EDSIndia/RCJ-Cluster/Documents/RCJ_Motor_Controller_CAN_Interface_Requirement_Specification (1).xlsx

RCJ Motor Controller CAN Interface Requirement Specification
SL.NO | CAN ID | Message Name | Cycle (ms) | DLC | Signal | Start Bit | Length (bits) | Signal Value Description | Requirement | Receiver | Remarks
1 | 0x230 | MCU_Status | 200 | 8 | Gear Position | 0 | 3 | 0=Invalid,1=Gear1,2=Gear2,3=Gear3,4=Reverse | Display current gear | Cluster
2 |  | MCU_Status | 200 | 8 | Brake Status | 3 | 1 | 0=OFF,1=ON | Brake indication | Cluster
3 |  | MCU_Status | 200 | 8 | Side Stand | 4 | 1 | 0=OFF,1=ON | Side stand alert | Cluster
4 |  | MCU_Status | 200 | 8 | Ready to Drive | 5 | 1 | 0=OFF,1=ON | Ready indicator | Cluster
5 |  | MCU_Status | 200 | 8 | Hall Sensor Fault | 6 | 1 | 0=No Fault,1=Fault | Fault indication | Cluster
6 |  | MCU_Status | 200 | 8 | Controller Fault | 7 | 1 | 0=No Fault,1=Fault | Controller fault | Cluster
7 |  | MCU_Status | 200 | 8 | Motor Fault | 8 | 1 | 0=No Fault,1=Fault | Motor fault | Cluster
8 |  | MCU_Status | 200 | 8 | Brake Warning | 9 | 1 | 0=No Fault,1=Fault | Brake error warning | Cluster
9 |  | MCU_Status | 200 | 8 | Throttle Error | 10 | 1 | 0=No Fault,1=Fault | Throttle error warning | Cluster
10 |  | MCU_Status | 200 | 8 | CAN Communication Fail | 11 | 1 | 0=OK,1=Fail | Communication failure | Cluster
11 |  | MCU_Status | 200 | 8 | Motor Temperature High | 12 | 1 | 0=Normal,1=High | Motor temperature high warning | Cluster
12 |  | MCU_Status | 200 | 8 | Parking status | 13 | 1 | 0 - OFF,1 - Parking | Vehicle parking status | Cluster
13 | 0x240 | MCU_Data | 200 | 8 | Vehicle Speed | 0 | 16 | km/hr | Display speedometer | Cluster
14 |  | MCU_Data | 200 | 8 | Motor Temperature | 16 | 16 | Temperature (°C) | Display motor temperature | Cluster
15 |  | MCU_Data | 200 | 8 | Odometer | 32 | 32 | Accumulated odo (km) | Display total vehicle runs | Cluster
