EDSIndia/RCJ-Cluster/Documents/DL0991-BL-W2-A.dwg-Model.pdf

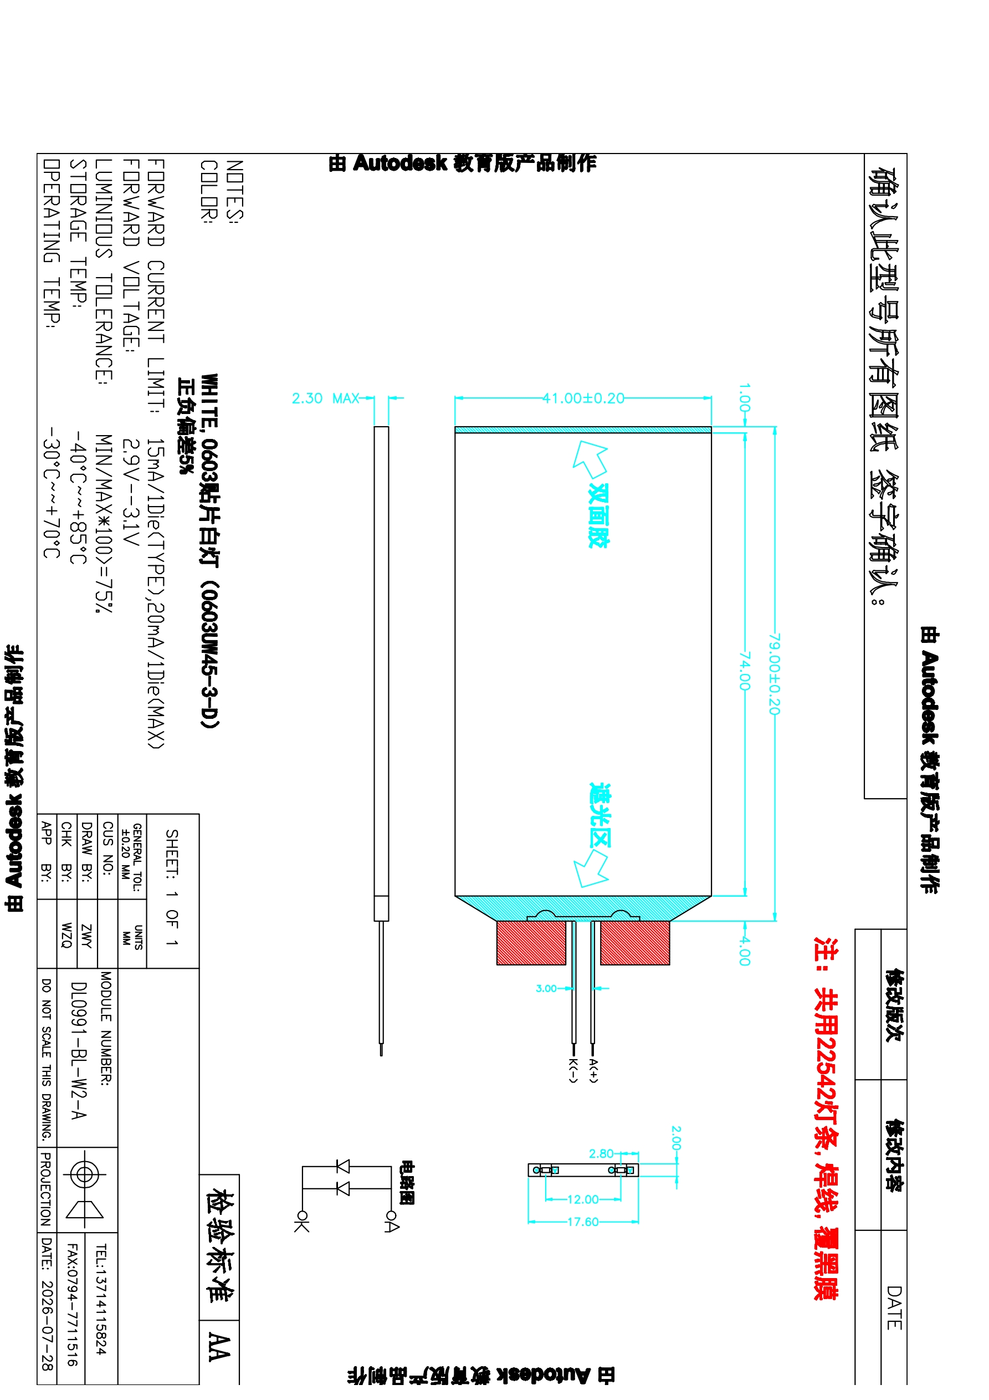
[picture p1: page 1]

1
