EDSIndia/RCJ-Cluster/Documents/EV_Cluster_Hardware_Validation_checklist.xlsx

Date :- 26/10/2026 |  | RCJ EV Cluster Display — Hardware Validation Parameters checklist |  | Project No :-
 |  |  |  | Project Date :- 26/10/2026
No. | Stage | Test Parameter | Test Procedure | Expected Result / Pass Criteria | Status
1 | 1. Visual inspection (power OFF) | PCB visual inspection and component orientation | Inspect PCB for damage, missing/wrong components, solder bridges, poor joints, and correct orientation/polarity of ICs, diodes, LEDs, transistors, andcapacitors. | No visible defects; placement and orientation match approved design. | Pass
2 | 2. Unpowered electrical checks | Unpowered short-circuit checks | With power disconnected, measure resistance from VIN to GND, +5V to GND, +3.3V to GND, and +3.3V_MCU to GND. Allow capacitors to settle. | No hard short | Pass
3 | 2. Unpowered electrical checks | Ground and connector continuity | Check ground continuity across board sections and verify key VIN/GND, SWD, CAN, and signal connector pins against the schematic. | Ground and connector mappings match the schematic; no unexpected opens or swaps. | Pass
4 | 3. First power-up | Current-limited first power-up | After unpowered checks pass, power from a SMPS with a conservative current limit based on the approved design. | Board starts without unexpected current draw, smoke, or heating. | Pass
5 | 3. Power rails | Power rails: +5V, +3.3V and +3.3V_MCU | Measure +5V, regulator +3.3V, and +3.3V_MCU at accessible test points / loads. | Each rail is within the approved design tolerance and component limits. | Pass
6 | 4. MCU and programming | STM32 SWD connection and firmware programming | Verify SWD connector pinout and target voltage, connect the debugger, then program and verify known test firmware. | Debugger identifies STM32G0B1CBT6; programming and verification succeed. | Pass
7 | 4. MCU and programming | MCU reset and startup | Check NRST and confirm the MCU executes test firmware after power-up and reset. | Reliable startup and reset recovery. | Pass
8 | 5. Display | Display driver supply and serial signals | Verify SM16306SJ supply/ground and observe SDI, CLK, LAT, activity during a display update. | Supply matches design; expected control/data activity is present. | Pass
9 | 5. Display | Display segments and COM scanning | Run diagnostic patterns to check every segment and COM1–COM4 scanning; test digits and all-segments-on/off patterns. | No missing/swapped/stuck segments; expected COM scan sequence. | Pass
10 | 5. Indicators | LED indicators and buzzer | Activate each fitted LED indicator channel and command the buzzer ON/OFF. | Correct indicator channel/colour; buzzer operates only when commanded. | Pass
11 | 6. Input sensing | Input sensing: speed, beam, indicators and EBV | Apply safe controlled signals within confirmed input limits to SPEED_SENSE, H/L_BEAM_SENSE, INDICATOR_L_SENSE, INDICATOR_R_SENSE, and EBV_SENSE. | Each input is detected correctly. | Pass
12 | 7. CAN interface | CAN transceiver supply and standby control | Measure CAN transceiver supply pins and exercise CAN_STB to check intended normal/standby behavior. | Rails match datasheet; standby control behaves as intended. | Pass
13 | 7. CAN interface | CAN bus wiring and termination | Verify CAN_H/CAN_L pin mapping, check for shorts, and confirm termination matches the intended network topology. | Correct wiring, no shorts, and termination matches network design. | Pass
14 | 7–8. CAN / integration | CAN communication and integrated power-cycle test | Exchange frames with a known-good CAN node/analyzer at matching bitrate, then run display/input activity and cycle board power. | Valid CAN frames; integrated functions respond correctly and board restarts reliably. | Pass
 | Prepared by Yousuf Pasha G | validation done by Yousuf Pasha G
