EDSIndia/RCJ-Cluster/Documents/EV_Cluster_Display_Rev6.pdf

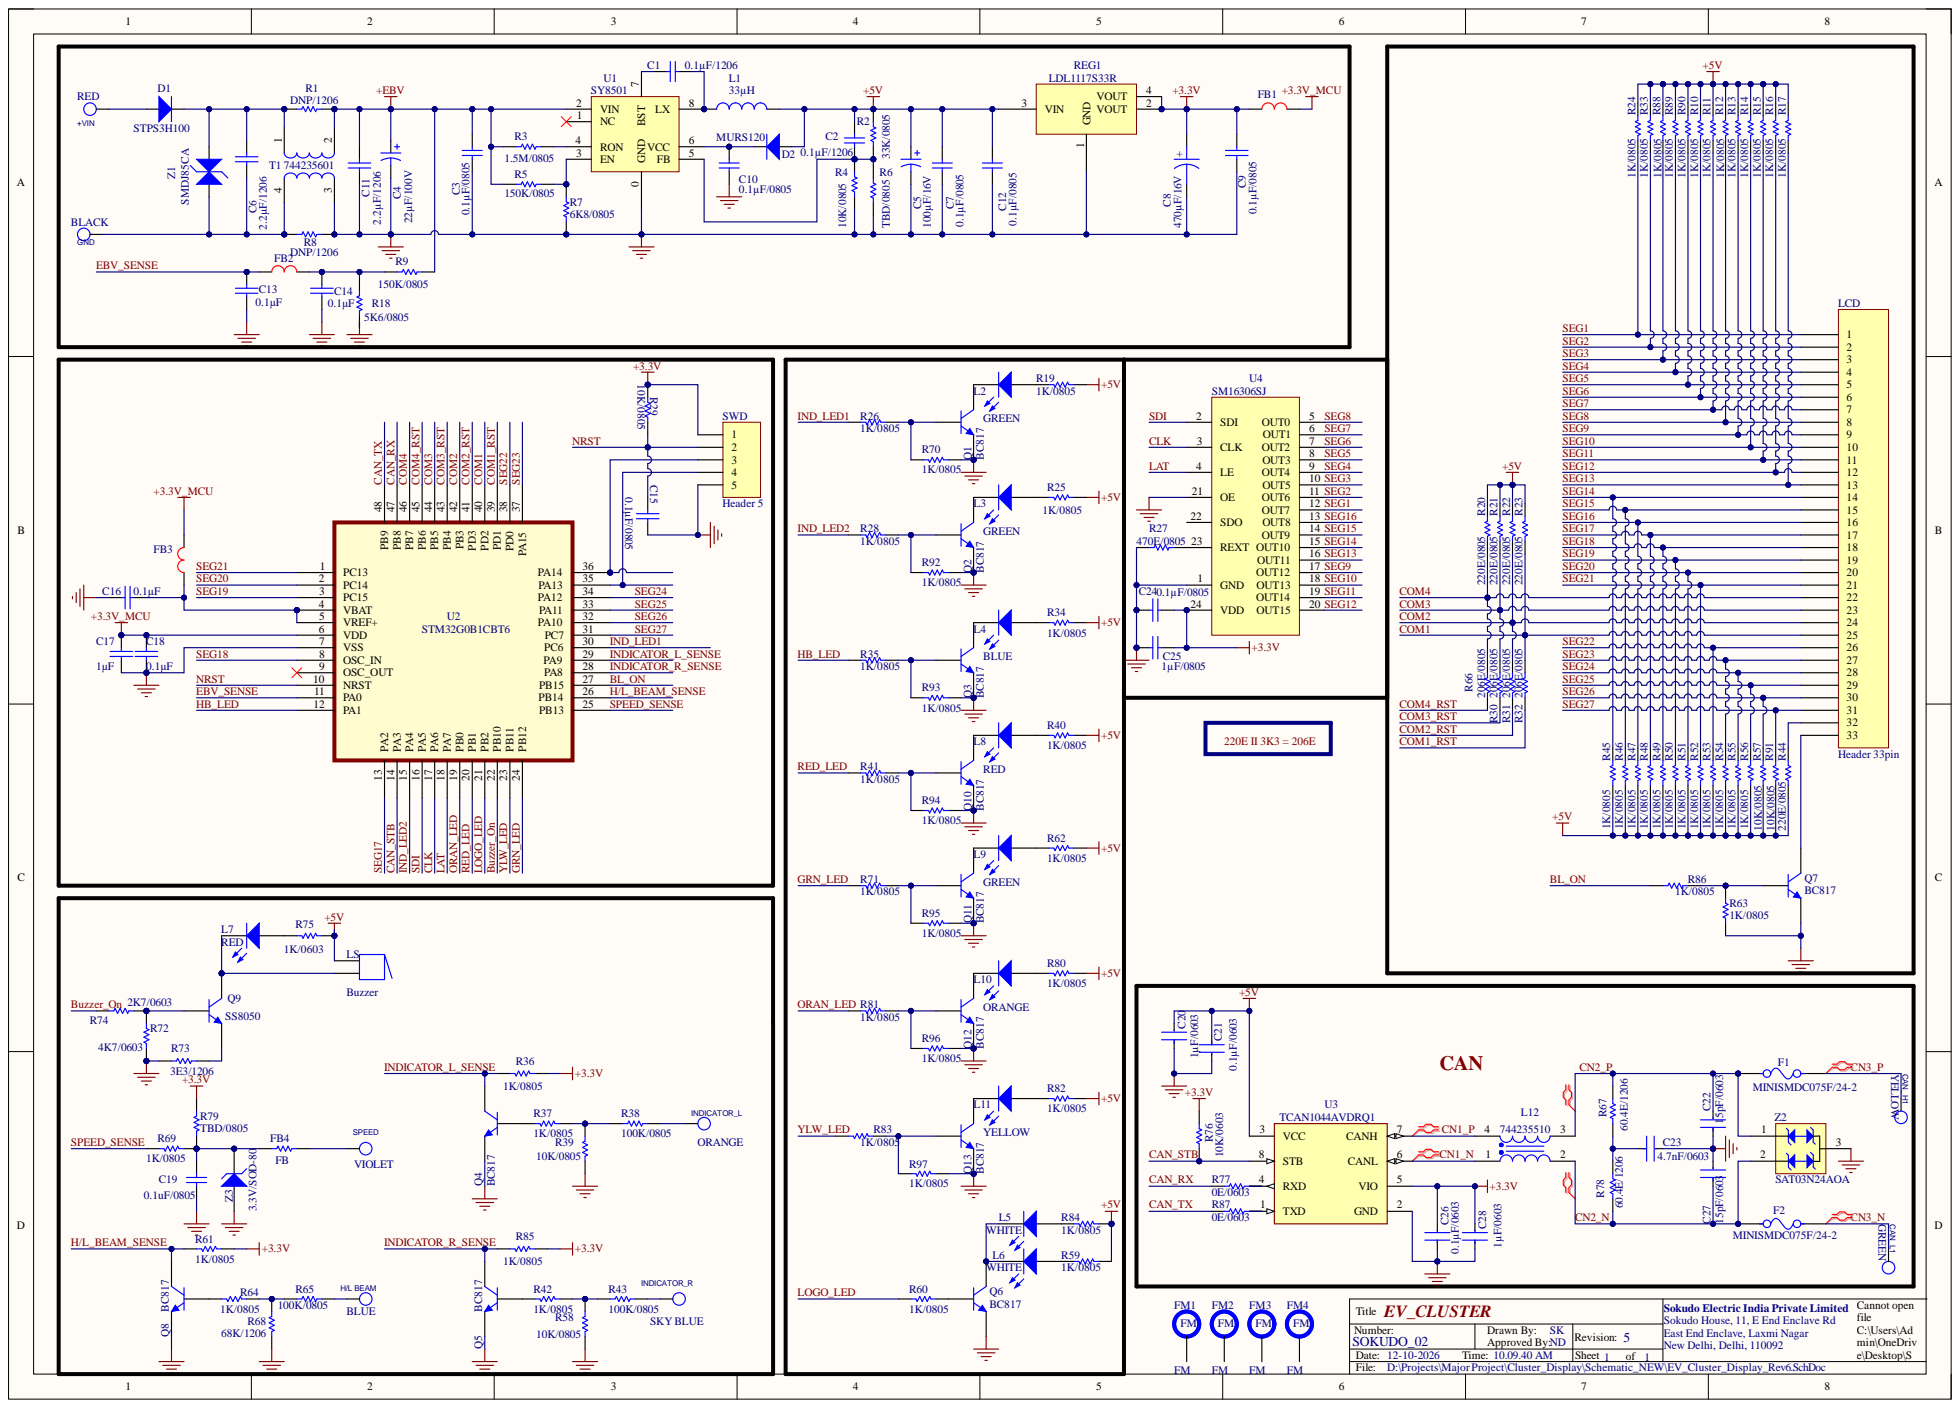
[picture p2: page 1]

Sokudo Electric India Private Limited
Sokudo House, 11, E End Enclave Rd
East End Enclave, Laxmi Nagar
New Delhi, Delhi, 110092
