EDSIndia/RCJ-Cluster/Firmware/Core/Src/FDCAN_DRIVER.c

#include "main.h"

// 
FDCAN_RxHeaderTypeDef   RxHeader;
FDCAN_TxHeaderTypeDef   TxHeader;

/*******************************************************************************
* Function Name  : RxCAN
* Description    : RECEIVE CAN FRAMES
* Input          : None 
* Output         : None
* Return         : None
*******************************************************************************/
//void RxCAN(void)
//{
////  switch(RxHeader.Identifier)
////  { 
//  case 0x02F4: 
//    Vehicle.BV=(RxData[1]<<8|RxData[0])/10;                                     //(voltage msb Hex_1 | voltage_lsb Hex_0)*0.1=xxxx volt
//    Vehicle.SOC=RxData[4];
//    break;
//    
//  case 0x05F4:
//    Vehicle.MaxTemp=(RxData[0])-50;                                             //-50 offset_  Battery temp Hex_1-50= xx *c
//    break;
//    
//  case 0x18F128F4: 
//    Vehicle.BC=(RxData[3]<<8|RxData[2])/10;                                     //Total Battery Capacity (AH)_Full Charge 
//    break;
//    
//  case 0x100:
//    Vehicle.BV = (RxData[0]<<8|RxData[1])/100; 
//    
//    break;
//  case 0x101:
//    
//    Vehicle.SOC = (RxData[4]<<8|RxData[5]); 
//    Vehicle.BC = (RxData[0]<<8|RxData[1])/100; 
//    break;
//  case 0x105:
//    Vehicle.MaxTemp = (RxData[0]<<8|RxData[1])/100; 
//    break;
//    
//    
//  case 0x18FF33D0:  
//    Vehicle.BC = (RxData[0]<<8|RxData[1]) /100;
//    break;
//    
//  case 0x18FF2FD2:
//    Vehicle.SOC = RxData[2];
//    break;
//   
//  case 0x18FF01D0:
//    Vehicle.BV  = (RxData[1] << 24|RxData[2] << 16|RxData[3] << 8|RxData[4])/100;
//    break;
//    
//  case 0x18FF31D0:
//    Vehicle.Batt_TEMP = RxData[0];
//    break;
//    
//    
//    
//  default: break;
//  } 
//}

void RxCAN(void)
{
  switch(RxHeader.Identifier)
  { 
    //    /* ================= DBC_EV file ================= */
    //  case 0x620:   // MCU Function
    //    {
    //      uint8_t  Power_Mode        = (RxData[3] >> 7) & 1;   // bit 31
    //      uint8_t  City_Mode         = (RxData[3] >> 6) & 1;   // bit 30
    //      uint8_t  Eco_Mode          = (RxData[3] >> 5) & 1;   // bit 29
    //      uint8_t  Reverse           = (RxData[3] >> 4) & 1;   // bit 28
    //      uint8_t  Regen             = (RxData[3] >> 3) & 1;   // bit 27
    //      uint8_t  Forward           = (RxData[3] >> 2) & 1;   // bit 26
    //      uint8_t  Ready             = (RxData[3] >> 1) & 1;   // bit 25
    //      uint8_t  Parking           = (RxData[3] >> 0) & 1;   // bit 24
    //      
    //      uint8_t  MotorOverTempErr  = (RxData[1] >> 7) & 1;   // bit 15
    //      uint8_t  ThrottleFault     = (RxData[1] >> 3) & 1;   // bit 11
    //      uint8_t  CtrlOverTempErr   = (RxData[1] >> 2) & 1;   // bit 10
    //      uint8_t  BrakeStateCtrl    = (RxData[1] >> 0) & 1;   // bit 8
    //      
    //      uint8_t  OverSpeedFault    = (RxData[0] >> 7) & 1;   // bit 7
    //      uint8_t  PosSensorFault    = (RxData[0] >> 4) & 1;   // bit 4
    //      uint8_t  MotorOverCurrErr  = (RxData[0] >> 2) & 1;   // bit 2
    //      uint8_t  UnderVoltageErr   = (RxData[0] >> 1) & 1;   // bit 1
    //      uint8_t  OverVoltageErr    = (RxData[0] >> 0) & 1;   // bit 0
    //      
    //      int32_t  Odometer_km       = (int32_t)(((uint32_t)RxData[4] << 24) | ((uint32_t)RxData[5] << 16) |
    //                                             ((uint32_t)RxData[6] << 8)  |  (uint32_t)RxData[7]);
    //     
    //    }
    //    break;
    //    
    //  case 0x621:   // MCU Working Info
    //    {
    //      int8_t   MCU_Temp_C        = (int8_t)RxData[0];                                  // degC
    //      int8_t   Motor_Temp_C      = (int8_t)RxData[1];                                  // degC
    //      int16_t  Motor_Speed_RPM   = (int16_t)((RxData[2] << 8) | RxData[3]);            // RPM
    //      float    Battery_Voltage_V = (int16_t)((RxData[4] << 8) | RxData[5]) * 0.1f;     // V
    //      int16_t  Battery_Current_A = (int16_t)((RxData[6] << 8) | RxData[7]);            // A
    //     
    //    }
    //    break;
    
    /* ========== CAN_protocol_Speedometer ========= */
    //  case 0x610:
    //    {
    //      uint8_t  OverVoltage_01    = (RxData[0] >> 0) & 1;
    //      uint8_t  UnderVoltage_02   = (RxData[0] >> 1) & 1;
    //      uint8_t  MotorOverCurr_03  = (RxData[0] >> 2) & 1;
    //      uint8_t  BlockedMotor_04   = (RxData[0] >> 3) & 1;
    //      uint8_t  PosSensor_05      = (RxData[0] >> 4) & 1;
    //      uint8_t  MOSFET_06         = (RxData[0] >> 5) & 1;
    //      uint8_t  PhaseDisconn_07   = (RxData[0] >> 6) & 1;
    //      
    //      uint8_t  BrakeInCtrl_09    = (RxData[1] >> 0) & 1;
    //      uint8_t  CtrlOverTemp_14   = (RxData[1] >> 2) & 1;
    //      Flag_Throttle_Fail       = (RxData[1] >> 3) & 1;
    //      uint8_t  MotorOverTemp_46  = (RxData[1] >> 7) & 1;
    // 
    //      
    //      if ((RxData[2] & 0x01U) != 0U)  Flag_parking = SET; else Flag_parking = RESET;                            
    //      uint8_t  ReadySign         = (RxData[2] >> 1) & 1;
    //      uint8_t  Forward           = (RxData[2] >> 2) & 1;
    //      uint8_t  Brake             = (RxData[2] >> 7) & 1;
    //      
    //    }
    //    break;
    //    
    //  case 0x611:
    //    {
    //      int8_t   MCS_Temp_C        = (int8_t)RxData[0];
    //      int8_t   Motor_Temp_C      = (int8_t)RxData[1];
    //      int16_t  Motor_Speed_RPM   = (int16_t)((RxData[2] << 8) | RxData[3]);
    //      float    DC_Voltage_V      = (int16_t)((RxData[4] << 8) | RxData[5]) * 0.1f;
    //      int16_t  DC_Current_A      = (int16_t)((RxData[6] << 8) | RxData[7]);
    //     
    //    }
    //    break;
    //    
  case 0x612:
    {
      avg_speed           = ((uint32_t)RxData[1] << 24) | ((uint32_t)RxData[2] << 16) |
        ((uint32_t)RxData[3] << 8)  |  (uint32_t)RxData[4];  //odo
      speed               = RxData[5];
    }
    break;
    
  case 0x620:
    {
      Vehicle.SOC          =   RxData[3];
      
      Vehicle.GearNo       =   RxData[4];
    }
    break; 
    
  case 0x611:
    {
      Vehicle.BV           = RxData[3];
      Vehicle.Batt_TEMP    = RxData[5];
    }
    break;
    
  }
  
}

/*******************************************************************************
* Function Name  : SOKUDO_BATT_REMOTE_FRAME
* Description    : This function is used to send Remote Frame 
* Input          : None 
* Output         : None
* Return         : None
*******************************************************************************/
//  void SOKUDO_BATT_REMOTE_FRAME(void)
//  {
//    if(remote_count)remote_count--;
//    else remote_count = 3;
//    switch(remote_count)
//    {
//    case 3:TxHeader.Identifier = 0x100;break;
//    case 2:TxHeader.Identifier = 0x101;break;
//    case 1:TxHeader.Identifier= 0x105;break;
//    default : remote_count = 1;break;
//    }
//    TxHeader.IdType              = FDCAN_EXTENDED_ID;
//    TxHeader.TxFrameType         = FDCAN_REMOTE_FRAME;
//    TxHeader.DataLength          = FDCAN_DLC_BYTES_0;
//    
//    HAL_FDCAN_AddMessageToTxFifoQ(&hfdcan1, &TxHeader, TxData); 
//    
// //   for(int i=0;i<10000;i++) __NOP();
//  }
void SOKUDO_BATT_REMOTE_FRAME(void)
{
  if (remote_count)
    remote_count--;
  else
    remote_count = 3;
  
  switch (remote_count)
  {
  case 3:
    TxHeader.Identifier = 0x100;
    break;
    
  case 2:
    TxHeader.Identifier = 0x101;
    break;
    
  case 1:
    TxHeader.Identifier = 0x105;
    break;
    
  default:
    remote_count = 4;
    break;
  }
  
  TxHeader.IdType          = FDCAN_EXTENDED_ID;
  TxHeader.TxFrameType     = FDCAN_DATA_FRAME;
  TxHeader.DataLength      = FDCAN_DLC_BYTES_8;
  TxHeader.ErrorStateIndicator = FDCAN_ESI_ACTIVE;
  TxHeader.BitRateSwitch   = FDCAN_BRS_OFF;
  TxHeader.FDFormat        = FDCAN_CLASSIC_CAN;
  TxHeader.TxEventFifoControl = FDCAN_NO_TX_EVENTS;
  TxHeader.MessageMarker   = 0;
  
  HAL_FDCAN_AddMessageToTxFifoQ(&hfdcan1, &TxHeader, TxData);
}


/*******************************************************************************
* Function Name  : CAN_Management
* Description    : This function is used to send Remote Frame and receive data
* Input          : None 
* Output         : None
* Return         : None
*******************************************************************************/
void CAN_Management(void)
{
  
  /* Transmit Remote Frame (Null data )*/
  if(Flag_Send_Frame){Flag_Send_Frame = RESET;SOKUDO_BATT_REMOTE_FRAME();}
  
  /*receive CAN Data and Store in Variable*/
  if (HAL_FDCAN_GetRxMessage(&hfdcan1, FDCAN_RX_FIFO0, &RxHeader, RxData) == HAL_OK)
  {
    RxCAN();
  }
  
  for(int i=0;i<10000;i++) __NOP();
}

/*******************************************************************************
* Function Name  : FDCAN_Config
* Description    : Receive CAN Frames from Battery 
* Input          : None
* Output         : None
* Return         : None
*******************************************************************************/
void FDCAN_Config(void)
{
  FDCAN_FilterTypeDef sFilterConfig ={0};
  
  /* Prepare Tx Header */
  TxHeader.Identifier          = 0x1ED;                                         //default Unique Id. as user wish
  TxHeader.IdType              = FDCAN_EXTENDED_ID;
  TxHeader.TxFrameType         = FDCAN_DATA_FRAME;
  TxHeader.DataLength          = FDCAN_DLC_BYTES_8;
  TxHeader.ErrorStateIndicator = FDCAN_ESI_ACTIVE;
  TxHeader.BitRateSwitch       = FDCAN_BRS_OFF;
  TxHeader.FDFormat            = FDCAN_CLASSIC_CAN;
  TxHeader.TxEventFifoControl  = FDCAN_NO_TX_EVENTS;
  TxHeader.MessageMarker       = 0;
  
  
  /* Configure Rx filter */
  sFilterConfig.IdType       = FDCAN_STANDARD_ID;                               //Standard_small size,EXTENDED_ID_ custom size  as per Protocol decided
  sFilterConfig.FilterIndex  = 0;
  sFilterConfig.FilterType   =  FDCAN_FILTER_RANGE;//
  sFilterConfig.FilterConfig = FDCAN_FILTER_TO_RXFIFO0;
  sFilterConfig.FilterID1    = 0x00;
  sFilterConfig.FilterID2    = 0x1FFFFFFF;
  
  if (HAL_FDCAN_ConfigFilter(&hfdcan1, &sFilterConfig) != HAL_OK)               //Config the FDCAN Configuration
  {
    Error_Handler();
  }
  
  /* Start the FDCAN module */
  if (HAL_FDCAN_Start(&hfdcan1) != HAL_OK)
  {
    Error_Handler();
  }
  
  if (HAL_FDCAN_ActivateNotification(&hfdcan1, FDCAN_IT_RX_FIFO0_NEW_MESSAGE, 0) != HAL_OK)  //FDCAN Alert Enable
  {
    Error_Handler();
  }
  SOKUDO_BATT_REMOTE_FRAME();
}



/*******************************************************************************
* Function Name  : CANDBC_Data_Extract
* Description    : Extracts and decodes a specific data value from a CAN message 
*                  frame based on bit position, byte order, and value type.
* Input         : uint8_t *can_data - Pointer to the CAN data frame (max 8 bytes)
*                 uint16_t Data_startBit - Bit position where extraction starts
*                 uint8_t Data_Length - Number of bits representing the data value
*                 uint8_t Byte_Order - Defines byte order (0: little-endian, 1: big-endian)
*                 uint8_t Value_Type - Specifies value type (0: unsigned, 1: signed)
*                 float Data_Factor - Scaling factor applied to extracted value
* Output        : None
* Return        : float - Decoded and scaled value
*******************************************************************************/
//float CANDBC_Data_Extract(const uint8_t *data,uint16_t start_bit, uint8_t bit_len,uint8_t byte_order, uint8_t value_type,float factor)
// {
//   
//   
//   
//   
//   
//   
//   
//   
// }
