EDSIndia/RCJ-Cluster/(commit log)

2026-10-26 Initial commit - RCJ Cluster
    [Book1.xlsx, EV_Cluster_Hardware_Validation_checklist.xlsx, RCJ_Motor_Controller_CAN_Interface_Requirement_Specification (1).xlsx, Status.xlsx]
2026-11-09 Updated RCJ Cluster firmware
    [CAN protocol_Speedometer (1).xlsx, DBC_EV (1).xlsx, RCJ_Cluster_Checklist.xlsx]
2026-11-10 Updated RCJ code afetr optimisation
    [EV_Cluster_Hardware_Validation_checklist.xlsx, RCJ_Cluster_Checklist.xlsx]
